ilina03/bootsense/hardware/photos/power source arduino and coin vibrator.jpg

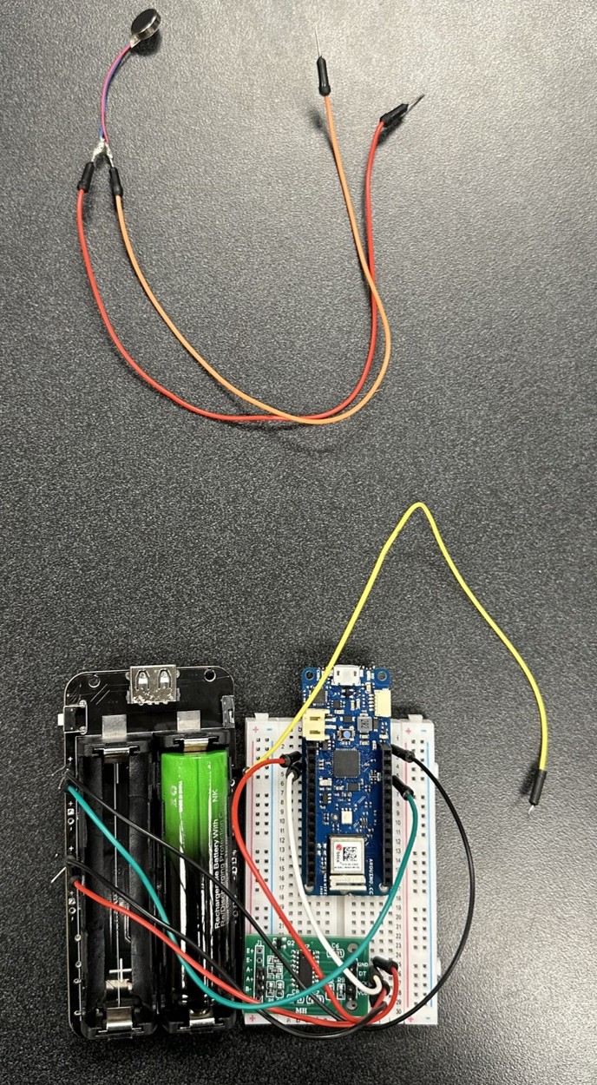
hardware/photos/power source arduino and coin vibrator.jpg
