ilina03/bootsense/hardware/photos/hx711 and arduino connections.jpg

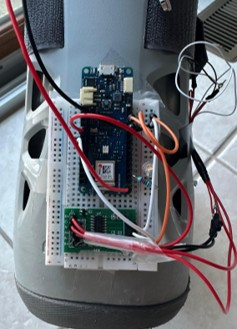
hardware/photos/hx711 and arduino connections.jpg
