ilina03/bootsense/hardware/datasheets/wheatstone bridge diagram.jpg

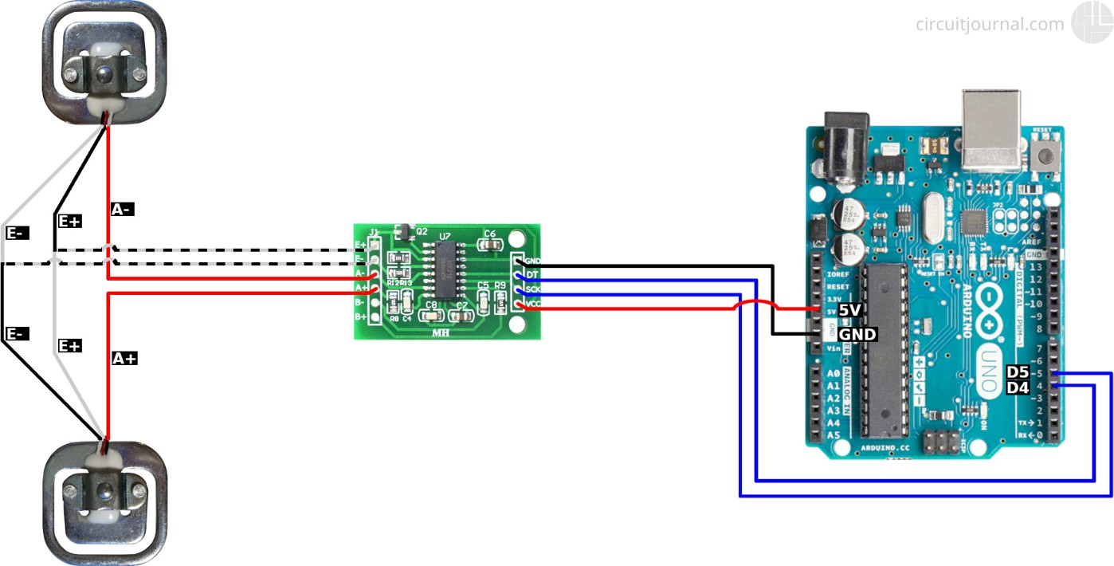
hardware/datasheets/wheatstone bridge diagram.jpg
