ilina03/bootsense/hardware/photos/load cells in boot.jpg

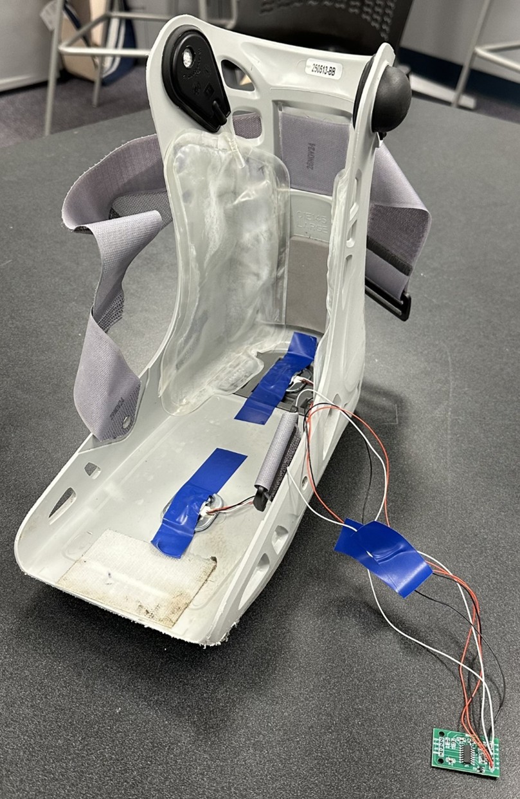
hardware/photos/load cells in boot.jpg
