ilina03/bootsense/hardware/photos/sensor placements under boot frame.jpg

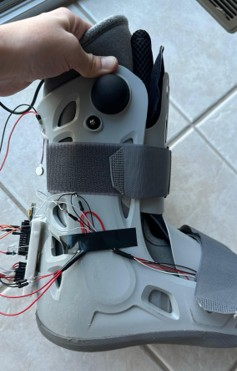
hardware/photos/sensor placements under boot frame.jpg
