ilina03/bootsense/hardware/schematic 1.png

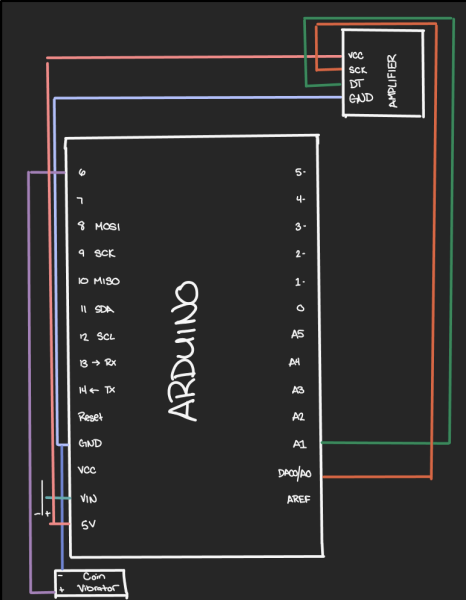
hardware/schematic 1.png
