ilina03/bootsense/hardware/schematic 2.png

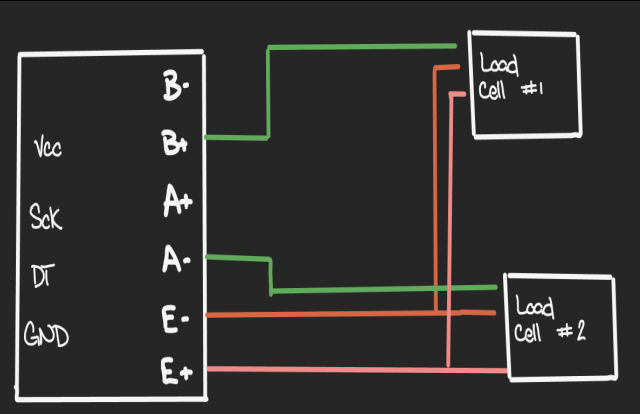
hardware/schematic 2.png
