ilina03/bootsense/hardware/datasheets/sensor with wheatstone bridge wiring.jpg

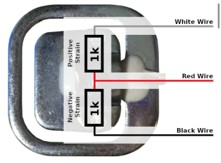
hardware/datasheets/sensor with wheatstone bridge wiring.jpg
