ilina03/bootsense/(commit log)

2026-04-28 Initial commit: firmware, hardware docs, README
    [BOM_bootsense.csv]
2026-04-29 wheatstone bridge schematic
    wheatstone bridge diagram with arduino and hx711 amplifier
2026-04-29 moving to hardware folder
    [BOM_bootsense.csv]
2026-04-29 moving to correct folder
    [bootsense_analog_test.ino]
